Scott-28/Rotary_Phone_Timer/images/5-Original_Inside.jpg

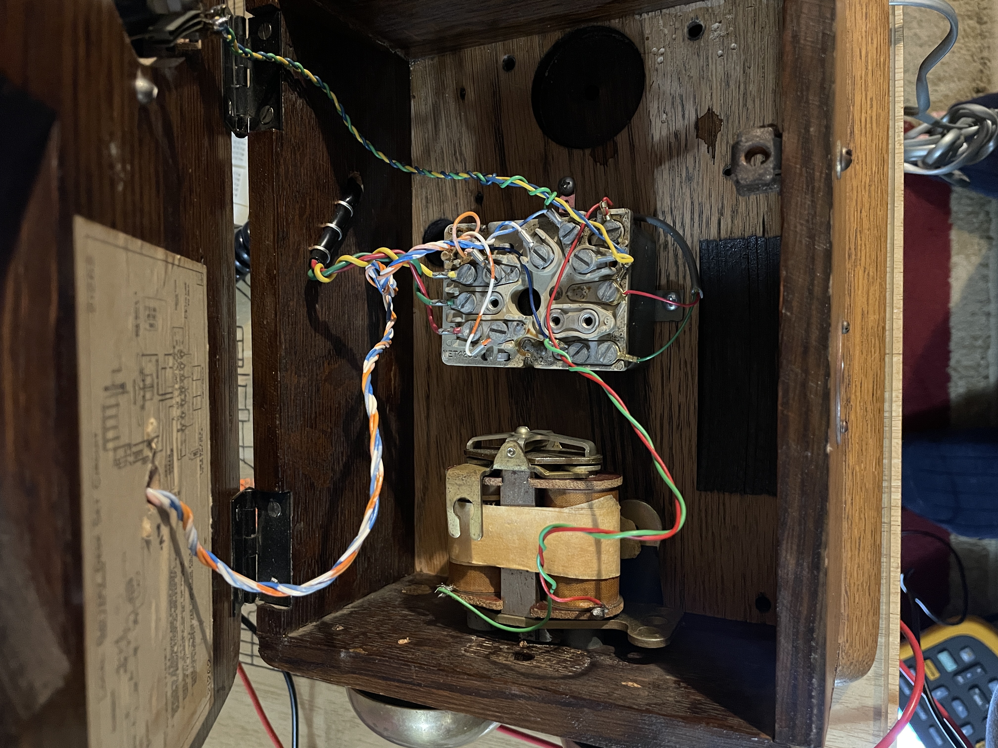
images/5-Original_Inside.jpg
