Scott-28/Rotary_Phone_Timer/docs/Schematic_Rotary-Phone-Timer_2024-03-14.pdf

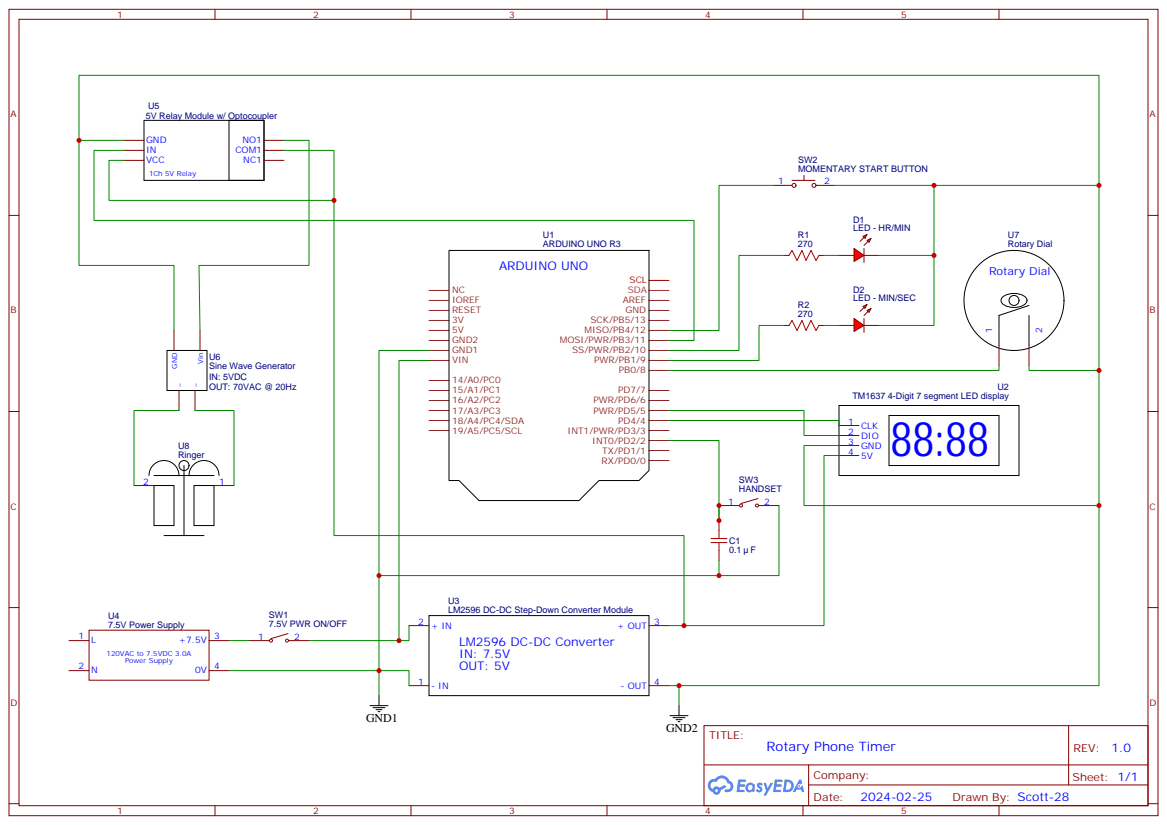
[picture p7: page 1]

TM1637 4-Digit 7 segment LED display

LM2596 DC-DC Step-Down Converter Module
LM2596 DC-DC Converter
OUT: 5V
