Scott-28/Rotary_Phone_Timer/images/4-Inside_Wiring.jpg

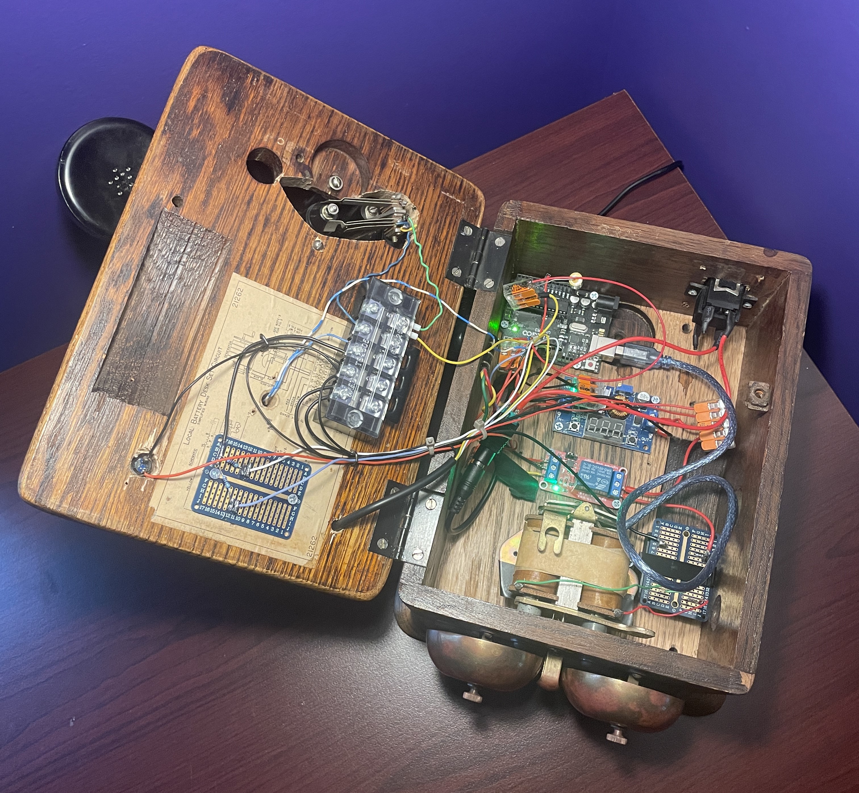
images/4-Inside_Wiring.jpg
