Scott-28/Rotary_Phone_Timer/(threads)

Thread 1 (2024-03-22):

Timer switches to incorrect number when values are high and you add time on the fly

Scott-28, 2024-03-22:
- When timer is a high number (ie. 99:97) in either hr/min or in/sec, when added time is more than 99:99 the timer resets to 00:XX
- When timer is at 59:40 in min/sec and time is added to it, it will not switch to hr/min mode
