Scott-28/Rotary_Phone_Timer/(commit log)

2024-03-18 Corrected comment in ln 21
    [Rotary_Phone_Timer.ino]
2024-03-18 docs: fixed schematic links
2024-03-18 docs: fixed schematic links in README
