Scott-28/Rotary_Phone_Timer/images/2-Brass_Labels.jpg

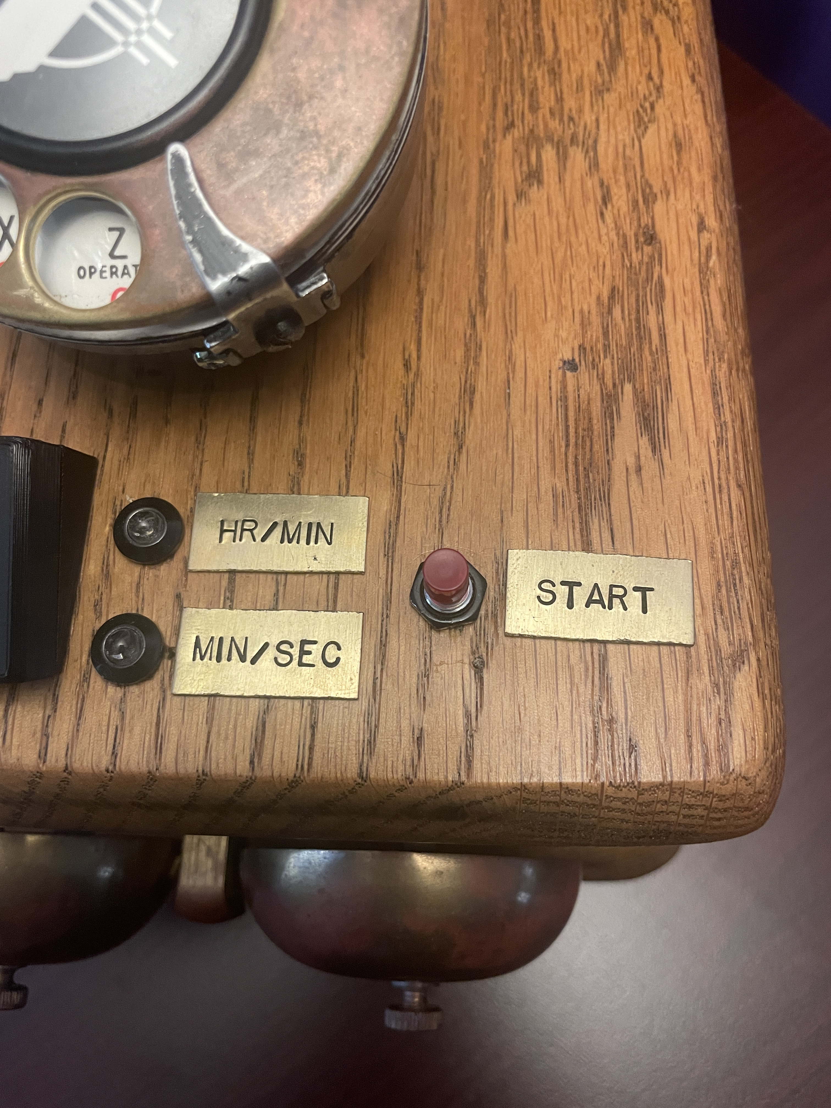
images/2-Brass_Labels.jpg
