Scott-28/Rotary_Phone_Timer/images/3-On_Off_Switch.jpg

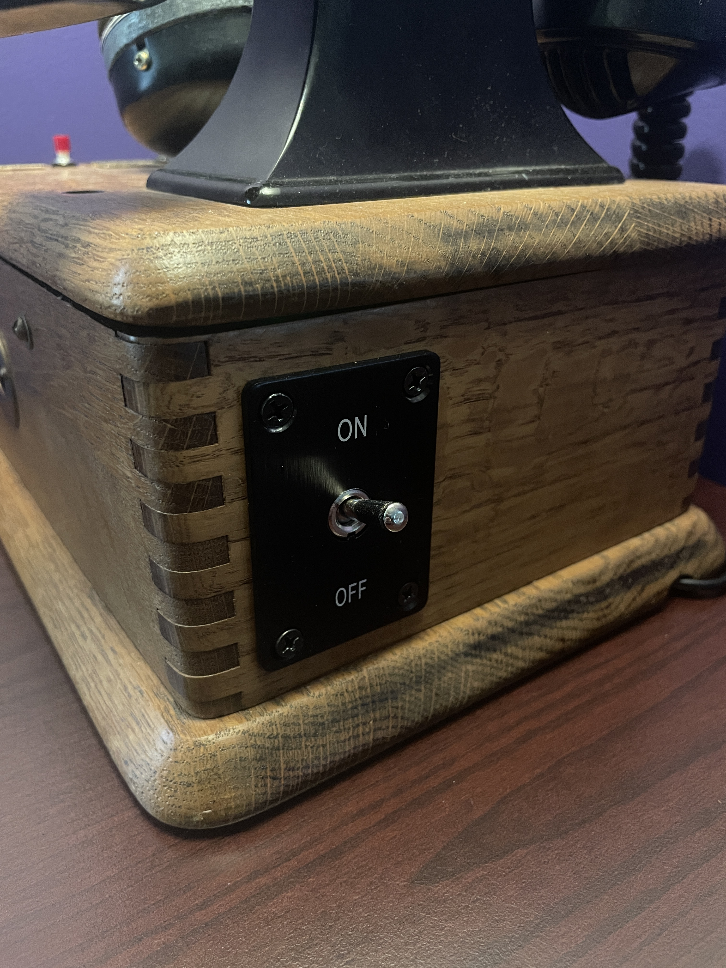
images/3-On_Off_Switch.jpg
